dalathegreat/Arduino-Coil-On-Plug/Documentation/CrudeSchematic.png

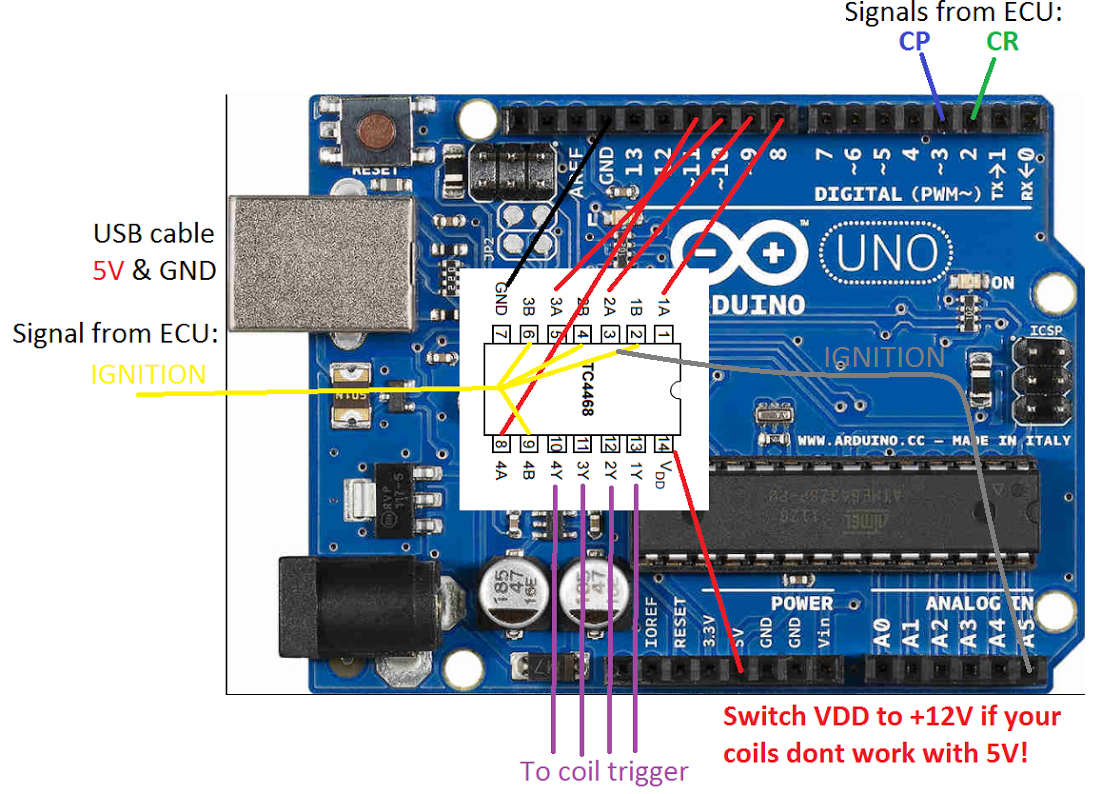
Documentation/CrudeSchematic.png
