dalathegreat/Arduino-Coil-On-Plug/(threads)

Thread 1 (2017-03-30):

Bootuptime too long

dalathegreat, 2017-03-30:
When the arduino coldboots it takes roughly 5 seconds before it gets to operational state. This is way too long, and might cause a situation where the engine starts rotating before the standstill check has been completed. This might cause the engine to never sync, requiring a restart of the whole system to get it to work again.

Bootup time needs to be <500ms, preferably as short as possible

rektbink, 2017-03-30:
In the email you made mention that you would have to write in a sync lost portion. Since an interrupt is needed to wake from sleep then the ignition ACC can be used as a sync enable, then a short delay to set the bit then power on/sleep. This way when the ignition is turned of sync is lost based on an interrupt and the unit goes to sleep. In theory, but I will give it a shot.

JKTUNING, 2017-03-31:
I don't think there is a need to put it into low power mode. There should be no reason that we can't get boot times MUCH faster.

Have you tried removing the original bootloader code all together?

dalathegreat, 2017-03-31:
Using Avrisp mkII as programmer, effectively overwriting bootloader, the boot time is **<0.1s**.

If you want to rewrite the bootloader to be faster, you still need a programmer. So my reasoning is that if you already have a programmer, you might as well get rid of the bootloader altogether.

You can even use another arduino as a programmer, so It wont add any extra cost for most people who want to do this.

I will leave this issue open still, but I would vote for just removing the bootloader.

rektbink, 2017-03-31:
I may not be seeing the forest through the trees here, and its due to my lack of experience here.
What is our goal? We want an open source and easily modifiable platform that allows the users to make changes as they see fit?

As I am more of a lay person in respect to your experience I think from my point of view this is becoming a complicated way of reprogramming the Arduino.

In regards to the code, is our concern for the code length based on the power consumption, efficiency in code design, reducing total memory usage, reducing cpu usage? Its starting to seem that we want an AVR platform, not an arduino.

I am going out on a limb here but it doesn't seem like the Atmega is the chip we really need to be basing this on. The picbasic program I wrote for the 16f88 destroys all these requirements. It boots instantly, uses significantly less power than the Atmega, the code body is much leaner, it can operate at the same frequencies at the Atmega and its less than half the cost, and it can be programmed via ICSP with an Arduino or PIC programmer.

I'm also looking at this from a hardware perspective and I am biased to the PIC since its the coding language I am most familiar with.

With all that being said I am going to throw my PIC design into the mix since the code and the hardware design is done. The board is on my OSH account.

rektbink, 2017-04-01:
Boot up time using optiboot is crazy fast. Car start perfectly with the new bootloader.

Thread 2 (2017-03-30):

When wasted spark is active, sequencing randomly breaks

dalathegreat, 2017-03-30:
Due to interference caused by the spark going off, garbage pulses will sometimes trigger interrupt pins. There is already a check inside the interrupt to see if it was a real pulse or a garbage one, which works perfectly well when using fully sequential ignition.

The problem however is when wasted spark is taken into use. Then the amount of garbage on the inputs gets so high that it eventually counts it as a valid pulse. This increments the counter by one, and the engine abruptly stops.

Figure out some way to better filter the pulses, or make changes to the hardware

rektbink, 2017-03-30:
I don't think you ever provided us code for the wasted spark setup? Or am I missing something?

dalathegreat, 2017-03-30:
Replace this:
  B00000001,
  B00000100,
  B00001000,
  B00000010};

With this:
  B00001001,
  B00000110,
  B00001001,
  B00000110};

This forces wasted spark to be active all the time. Useful for quickly testing

rektbink, 2017-03-30:
Does it take longer to start OR does it fail to start sometimes when using this method?

dalathegreat, 2017-03-30:
It sometimes fails to start because the first spark events cause immediate failure of the sequencing. Be ready on the reset button.

dalathegreat, 2017-05-02:
Setting this one as resolved

No further observations of sync loss after taking v1.4 into use. Engine ran successfully on road up to 8000rpm. Total runtime was over 45 minutes.

I will keep the other issue case open https://github.com/dalathegreat/Arduino-Coil-On-Plug/issues/6 until someone else has confirmed it working on their setup.

Closed 2017-05-02.

Thread 3 (2017-03-31):

Add rpm measurement

dalathegreat, 2017-03-31:
RPM measurement is needed for smart activation/de-activation of optional wasted spark operation. Before this can be implemented, the other issue with disturbances from running wasted spark needs to be resolved.

dalathegreat, 2017-03-31:
Branch 'dalathegreat-rpm-test' contains prototype rpm measurement. Before this can be even considered for merging with main branch wasted spark needs to be stable.

rektbink, 2017-04-01:
You may want to consider using sequential ignition during cranking due to the ECU using batch injection during cranking. It may be the reason you have a fail to start sometimes when using wasted spark.

majdimohammad, 2019-08-23:
Hello, any update with RPM measurement? I tested, and detect the sequence in fine. But it will be problem if car switch on ig 2, not totally off the arduino. The program stuck in syncAchieved. After resume crank, it will fire at wrong position. If any how we can reset the loop without switch off the arduino, these will solve the issue.

Since it using interrupt, Pulsein no longer available, it will interupt the firing sequence...

rektbink, 2019-08-23:
Are you using wasted spark or sequential ignition mode?

majdimohammad, 2019-08-24:
Im using sequential mode.. but using waste spark also same i believed. If any way we can reset the syncAchieved back to Zero 0 after running without pressing reset button or turn off the arduino?

dalathegreat, 2019-08-24:
Yes, very easy to do! Just add a timer that starts counting if we haven't had any interrupts trigger for a time (say 2-5second), and if we haven't gotten any interrupts, set syncAchieved  == 0

majdimohammad, 2019-08-24:
Nice thank you, it work now. I used long press button code. When no pulse, CK signal will go direct HIGH for 2-3 second, and it will reset the syncAchieved. So far tested on engine simulation no random firing. It will reset and start new ignition firing when only after CP detect. Will test on real engine next week. I will update again.

majdimohammad, 2019-08-24:
If these work, we can start convert 4G63 batch injector and waste spark to sequential system ;)

dalathegreat, 2019-08-24:
@majdimohammad Cool! Do post the code if you want to! 👍 Good luck with the project!

majdimohammad, 2019-08-24:
Yes i will post the code after the test. Is anyone have sr20 waveform fullcycle.. so i can compare and count the trigger between CK and CP?

rektbink, 2019-08-24:
I'll dig out a waveform, unless Daniel has one handy. Basically cylinder 4 has a large window, and cly 1-3 has small windows. The large window is 12 pulses low to high, and the small window is 4 pulses low to high. There is appx 90 pulses between windows. The ECU decides where in the cyl windows to fire the ignition.

akilamarquiel, 2019-08-24:
Hi guys. Is it possible to run this on different engine? Like honda d15y. Thank you

rektbink, 2019-08-24:
No, the sr20 and the d15 use different methods of engine position tracking. A majority of the Honda's use a hall sensor on the crank to track engine position. The issue being is a variable reluctance sensor is needed to convert the hall signal to a logic signal.

akilamarquiel, 2019-08-24:
Oh i see. How sad. 😥 anyways thanks for your fast reply.. maybe i should try speeduino instead. Thnx again. Cheers👍

majdimohammad, 2019-08-24:
> I'll dig out a waveform, unless Daniel has one handy. Basically cylinder 4 has a large window, and cly 1-3 has small windows. The large window is 12 pulses low to high, and the small window is 4 pulses low to high. There is appx 90 pulses between windows. The ECU decides where in the cyl windows to fire the ignition.
>
> An oscilloscope is really helpful in this situation.

Yes, i used 8 channel hantek oscilloscope ;) without these tool, it we will never know what happen in there.

If u have a full picture of trigger disk also will help..

majdimohammad, 2019-08-27:
[https://ibb.co/HnD0tS1](url)
[https://ibb.co/dpTDw04](url)

majdimohammad, 2019-08-27:
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

Thread 5 (2017-03-31):

Needs testing with smart coils

dalathegreat, 2017-03-31:
Application has only been tested with dumb coils;
-Honda CBR600 i4 coils
-AEM 30-2840 4-channel coil driver

This case can be set to resolved once the code has proven successful with smart coils.

rektbink, 2017-04-01:
VWAG coils tested and working well.

dalathegreat, 2017-04-01:
Superb, setting this issue to resolved!

Closed 2017-04-01.

Thread 6 (2017-04-01):

Arduino assigning output to wrong pin

rektbink, 2017-04-01:
During my testing I found that occasionally when the arduino would sync it would flip the logic 180 degrees out. For example I currently have one VWAG coil plugged into cylinder 4. During start up the Arduino syncs and the logic is correct. After a minute the logic will flip 180 degrees and now the pin for cyl four is now firing number two.

I am not sure how this could be caused by one coil being plugged in, but within the week I plan to install all four and try again.

Can you make a branch that has the sync enabled for every cycle?

dalathegreat, 2017-04-01:
I will start writing a branch that syncs every revolution so you can test with that.

Although, having only one coil hooked up next to the high voltage spark plug wires might be just what caused this. It would be interesting to see if hooking up all 4 COPs would make it stable. I can rev just fine to 8000rpm in sequential mode.

dalathegreat, 2017-04-01:
Another solution would be to also sample in the 'ECU ignition' signal into the atmega, and disable interrupts while the sparkplug is firing. That would make it extremely robust, but again require hardware changes to any boards you are sketching.

dalathegreat, 2017-04-02:
Prototype branch "dalathegreat-ignition-sync-fix" created, heading out to test this on a real engine now.

dalathegreat, 2017-04-02:
Wow! I just returned from testing, and it worked! I can now run wasted spark without it breaking the sequencing!

Try it and see if it helps your situation too! All it requires in hardware terms is a new jumperwire from IGNITION -> Pin28 , See the grey wire in this crude sketch.
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

Be sure to use the "dalathegreat-ignition-sync-fix" branch, it is labeled proto v0.01

rektbink, 2017-04-03:
That is great news! Good idea sampling the ignition. I should be able to test this on Saturday or Sunday. I need to get a Non RR valve cover so I can fit these VWAG coils. The RR valve cover is too tall for #1 to sit properly.

dalathegreat, 2017-05-02:
Please retry with v1.4 stable release , this hopefully solves your issue :)

Thread 8 (2023-05-06):

Adapt for mazda FE Cylinder

Mykimike25, 2023-05-06:
Hi

I'm want to adapt to a Mazda FE with a CB Black box controller.

I get a standard negative pulse for use with a 12v coil. Can this be used as the yellow ignition ecu input? Or do I need to convert to 5v?

Is the Sr20 pulse 5v?

amrikarisma, 2024-04-27:
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

I plan to use this code as a reference for using COP on the Mazda BP05 Engine. Have you succeeded?

BTW, on my Mazda 323 distributor, it uses 2 sensors, each giving a 5v signal.
