dalathegreat/Arduino-Coil-On-Plug/(commit log)

2017-03-26 Initial v1.0 version
    Tested on real engine with an Arduino Uno. See electrical drawings for more info.
2017-03-29 v1.1 Tested on engine!
    Changelog v1.1 , Main changes are code speedup improvements
    -Moved around critical code sections:
    -Setup script now runs interrupt enabling last. This should help if CPU doesn't have time to boot before engine starts rotating
    -SyncAchieved instantly disables interrupt of CP before doing anything else (not sure if really needed but a very good idea)
    -"state = !state;" moved inside the syncAchieved section to speed up the interrupt at high rpms
    -"pos = 0;" the other reset moved inside the syncAchieved section to speed up the interrupt at high rpms
    -Disabled unneeded code
    -"volatile byte ref = 0;" global variable no longer needed, removed to save memory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
    [COP.ino]
2017-03-29 v1.2 Stable & tested on engine!
    Changelog v1.2 , Main improvement is digital output speed
    - Removed the costly if operators from main while loop
    - Added a firing order table. This will respond faster to sequencing the next cylinder that should fire.
2017-03-29 v1.3 Stable and tested on engine!
    Changelog v1.3 , Main improvement: ISR1 Interrupt speedup
    -Instead of using two if's in main ISR1, switched to if-else to speed up processing
    -Instead of using two if's to check state before sync, switched to if-else to speed up processing
    -Defined fireOrder table as byte instead of int to save memory (thanks John!)
    -Removed PORTB writing in setup, not needed according to documentation. Should speedup setup.
2017-04-02 Prototype for fixing sync
    This version also samples in ignition events on pin28, and should in theory help to fix the desync
    [COP.ino]
2017-04-02 Initial schematic added
    Feel free to improve this one :)
